rkhamilton/ArcadeControlPanel/images/applied-art.jpg

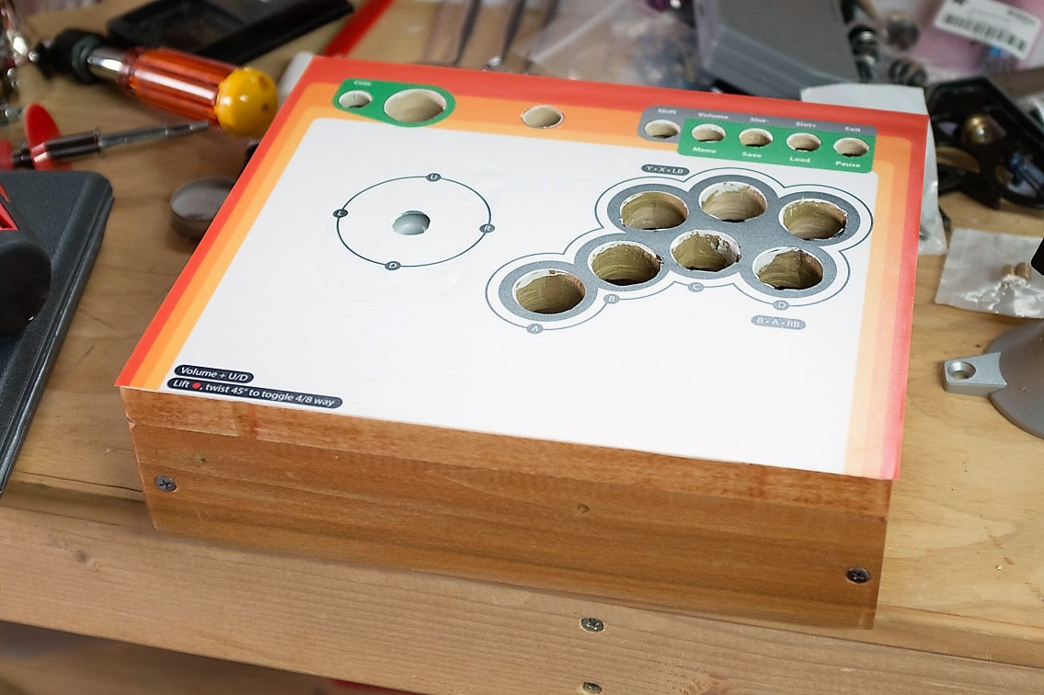
images/applied-art.jpg
