rkhamilton/ArcadeControlPanel/images/hole-template.jpg

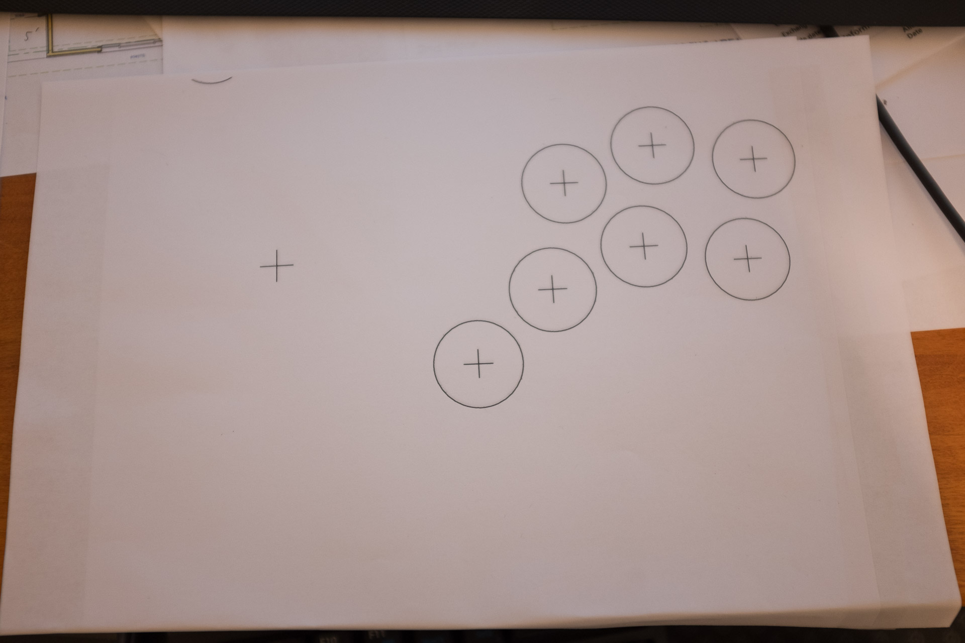
images/hole-template.jpg
