rkhamilton/ArcadeControlPanel/images/top-panel.jpg

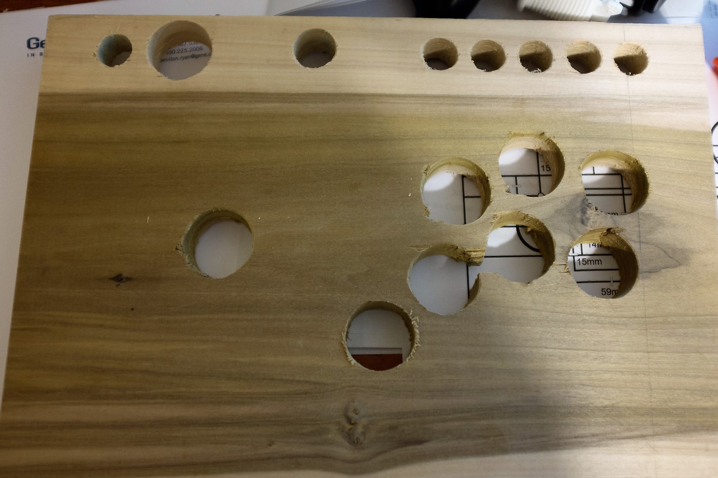
images/top-panel.jpg
