rkhamilton/ArcadeControlPanel/images/wired-ground.jpg

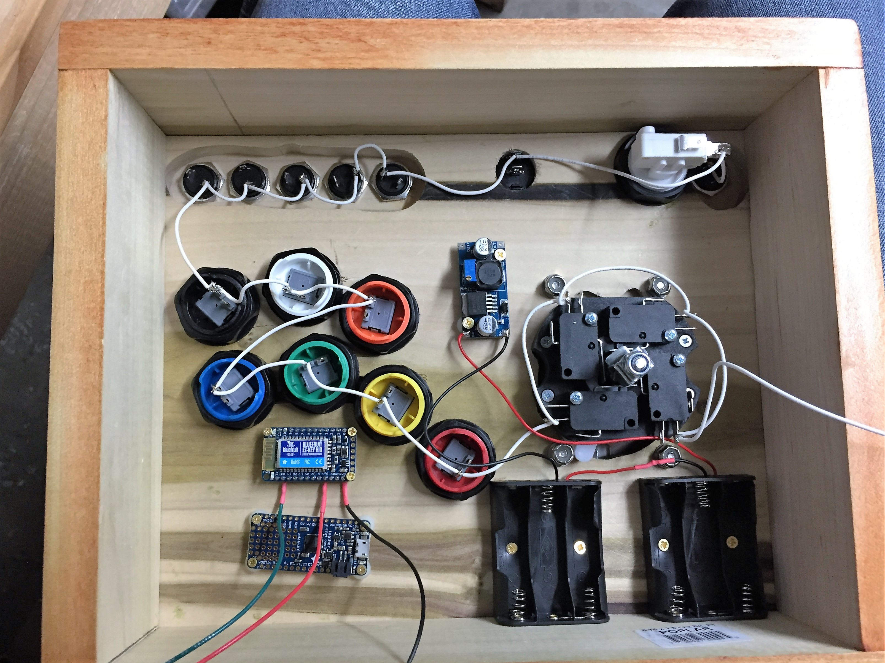
images/wired-ground.jpg
