rkhamilton/ArcadeControlPanel/control_panel_art/control-panel.pdf

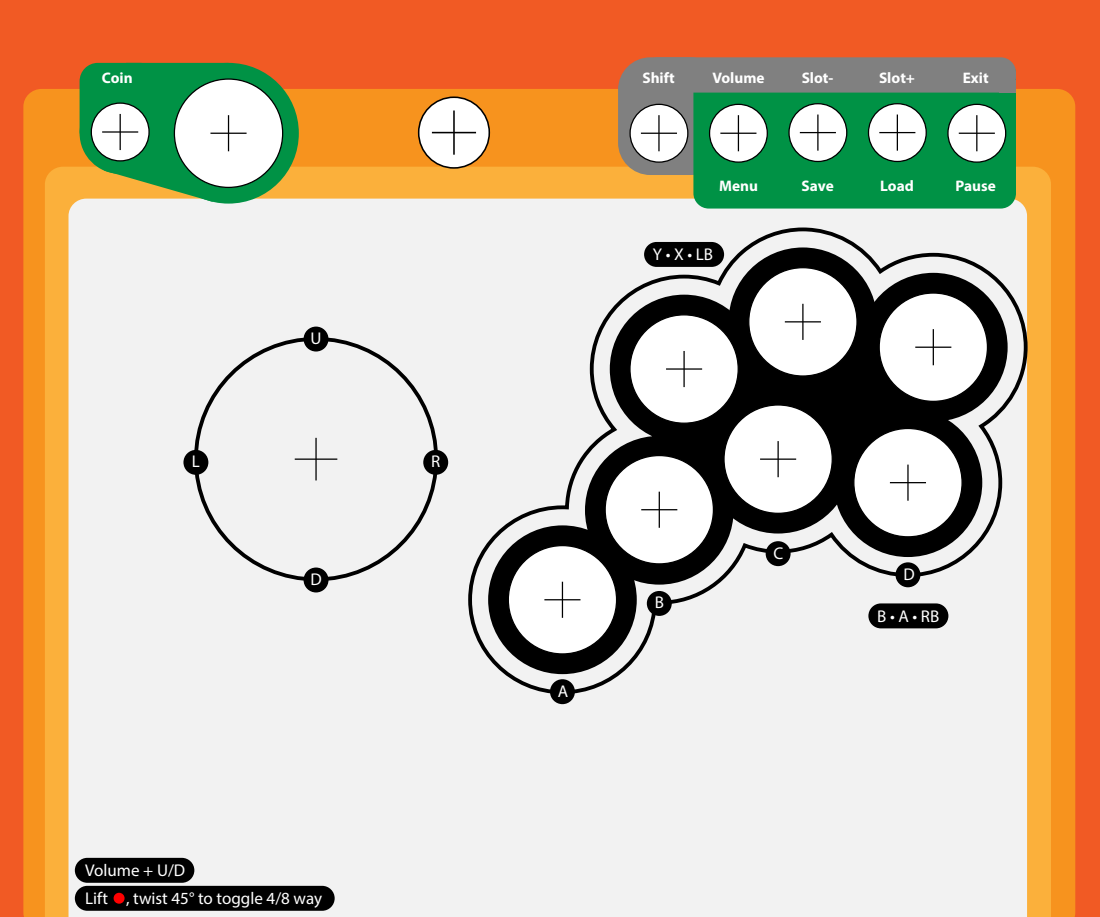
[picture p13: page 1]
Menu; Save; Load; Pause; Coin; Shift; Volume; Slot-; Slot+; Exit

Volume + U/D
Lift , twist 45° to toggle 4/8 way •
