rkhamilton/ArcadeControlPanel/images/art-test-fit.jpg

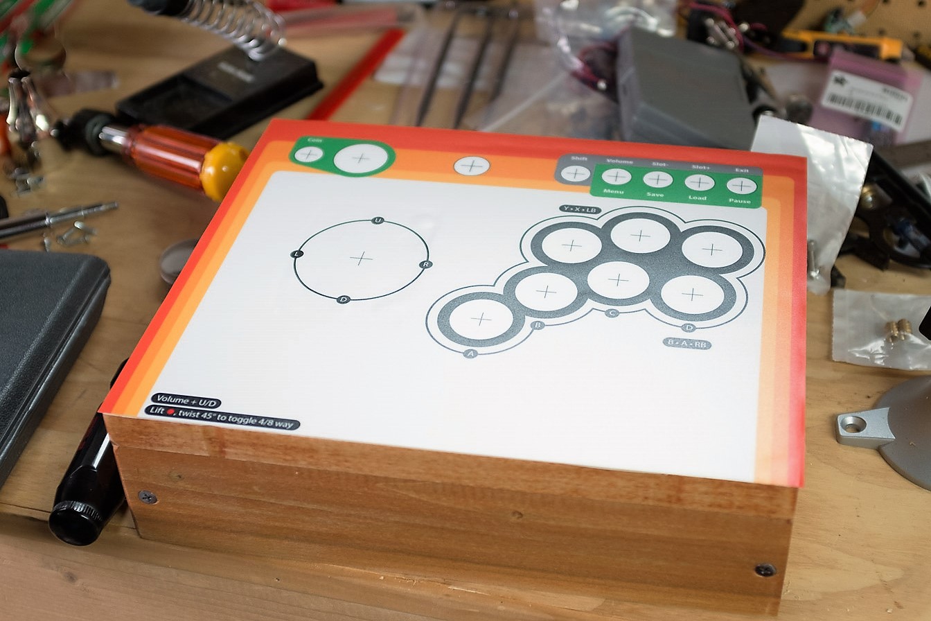
images/art-test-fit.jpg
