rkhamilton/ArcadeControlPanel/images/enclosure-test-fit.jpg

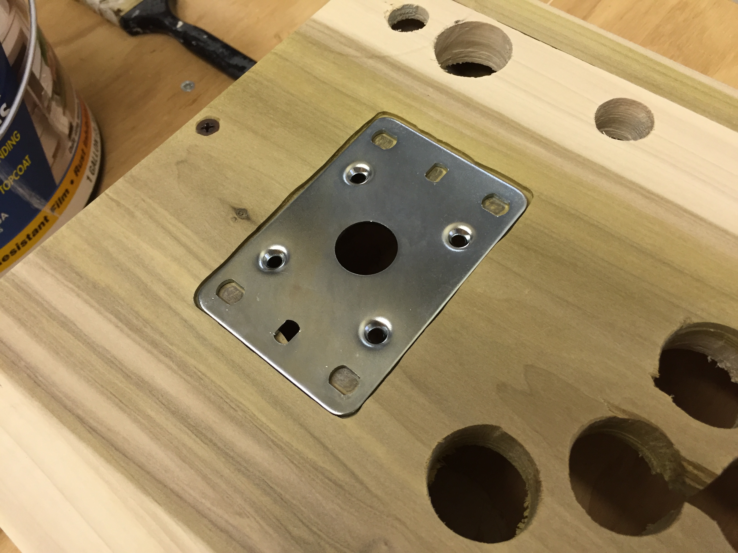
images/enclosure-test-fit.jpg
