rkhamilton/ArcadeControlPanel/images/test-fit-joystick.jpg

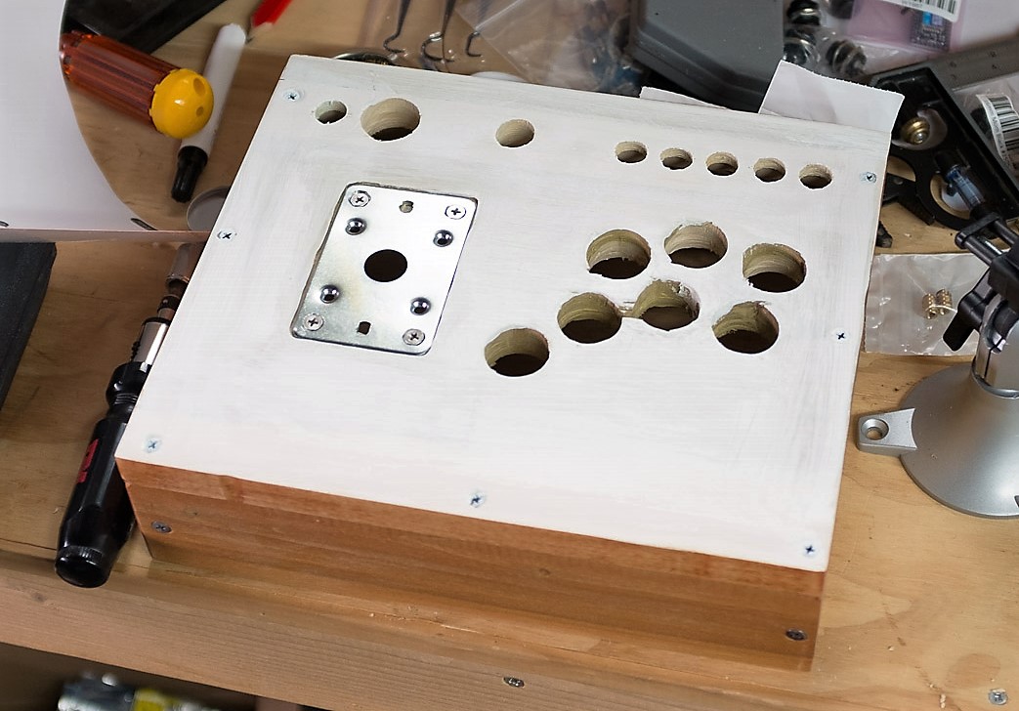
images/test-fit-joystick.jpg
