rkhamilton/ArcadeControlPanel/(commit log)

2016-04-30 cleaned up button labels
2016-04-30 fixed double-processing button presses
    error where when reading the button state I was reprocessing the button
    state. Rapid button presses were missed.
2016-11-17 changed shift button from keyboard to toggle
    retroarch doesn't differentiate between letter cases. I can't use
    capital letters to trigger different admin functions. Now pressing the
    shift button causes the panel to send a different letter than unshifted.
    [es_input.cfg, retroarch.cfg]
